naushad-rahman/LIFSrProj_F15/README.md

**Repository for Senior Project ECEn 490 Section 1, Fall 2015, BYU**
