naushad-rahman/LIFSrProj_F15/DSP/digital_filter_explore/150706_zero_phase_FIR_notes.png

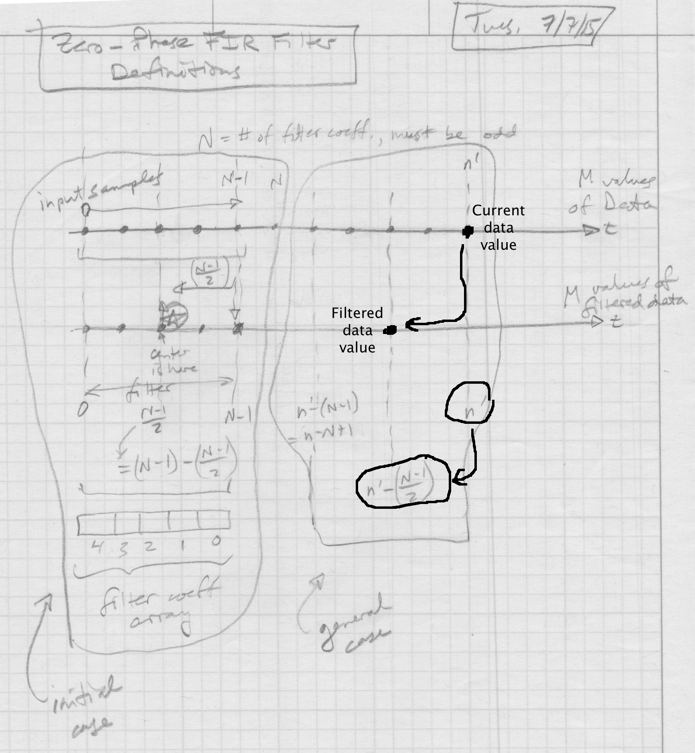
DSP/digital_filter_explore/150706_zero_phase_FIR_notes.png
