naushad-rahman/LIFSrProj_F15/High Voltage/HV Hardware LTSpice/Faulty HV schematic original.PNG

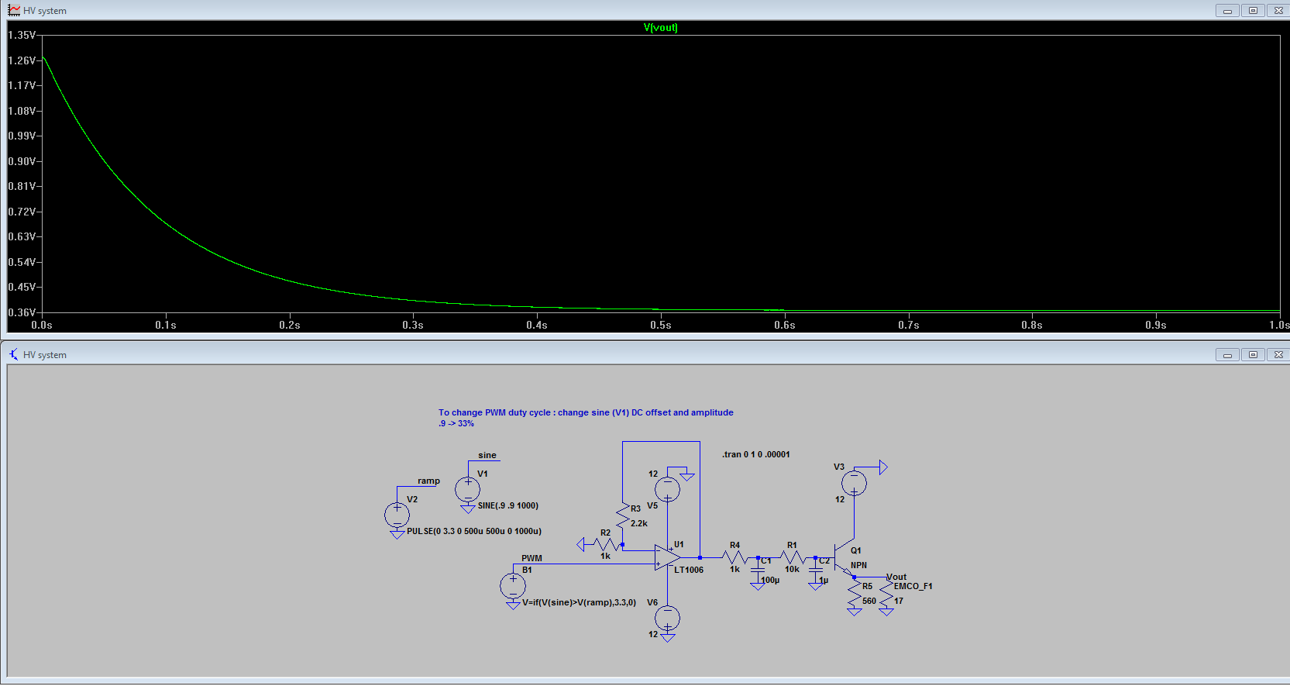
High Voltage/HV Hardware LTSpice/Faulty HV schematic original.PNG
