naushad-rahman/LIFSrProj_F15/High Voltage/HV Hardware LTSpice/HV change.PNG

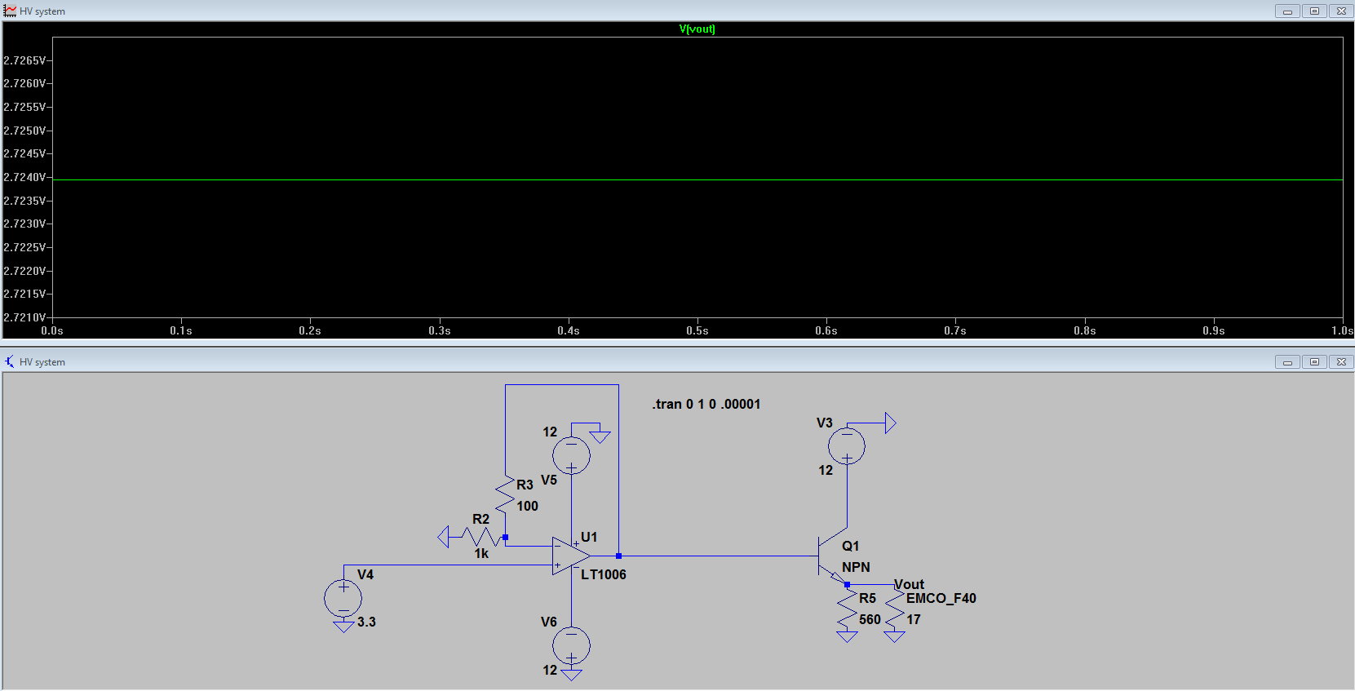
High Voltage/HV Hardware LTSpice/HV change.PNG
