naushad-rahman/LIFSrProj_F15/Laser_Driver/laser_current.jpg

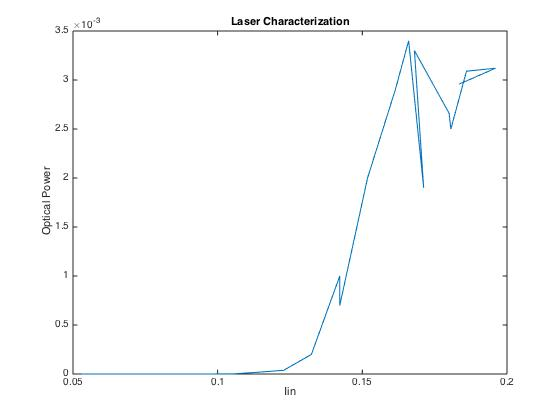
Laser_Driver/laser_current.jpg
