naushad-rahman/LIFSrProj_F15/Laser_Driver/laser_voltage.jpg

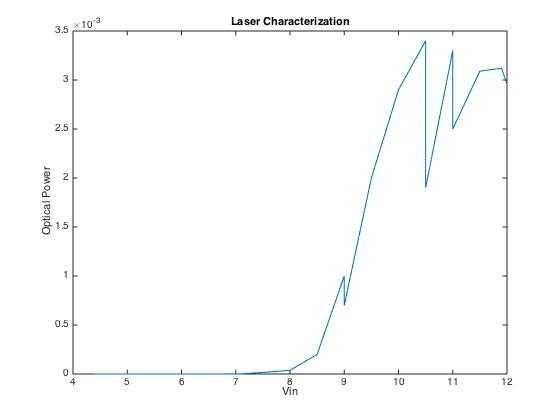
Laser_Driver/laser_voltage.jpg
