naushad-rahman/LIFSrProj_F15/CAD/Optical_Bench_current.stl

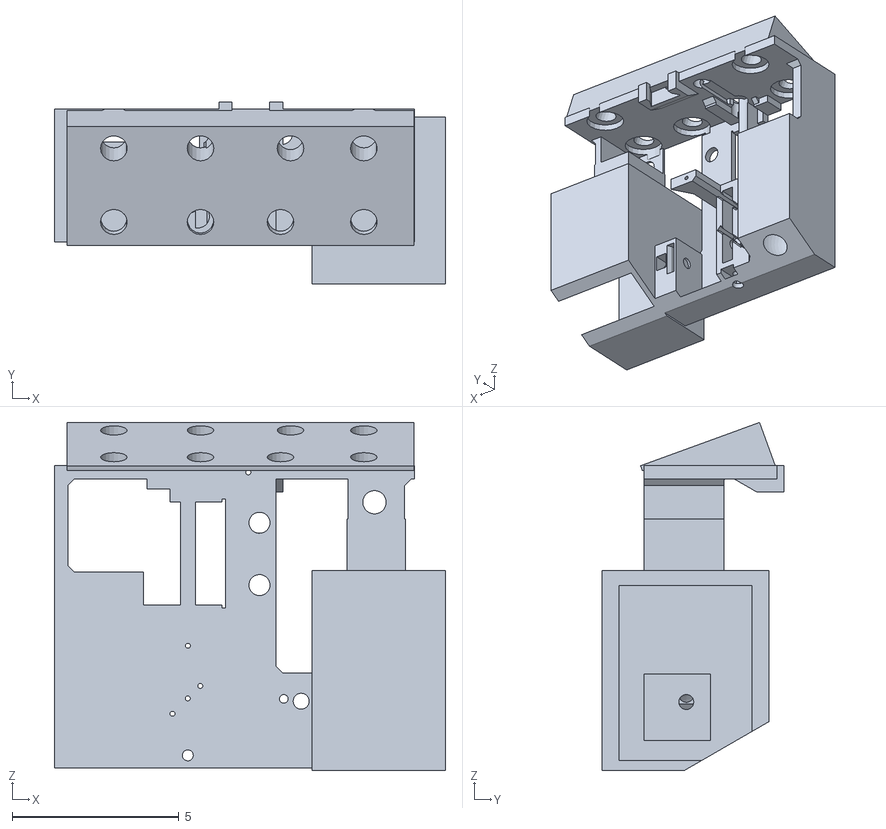
[picture p6: CAD file, 2015-12-16]
CAD/Optical_Bench_current.stl
11.7 x 5.45 x 10.4
