naushad-rahman/LIFSrProj_F15/CAD/sampleholderdraft5.stl

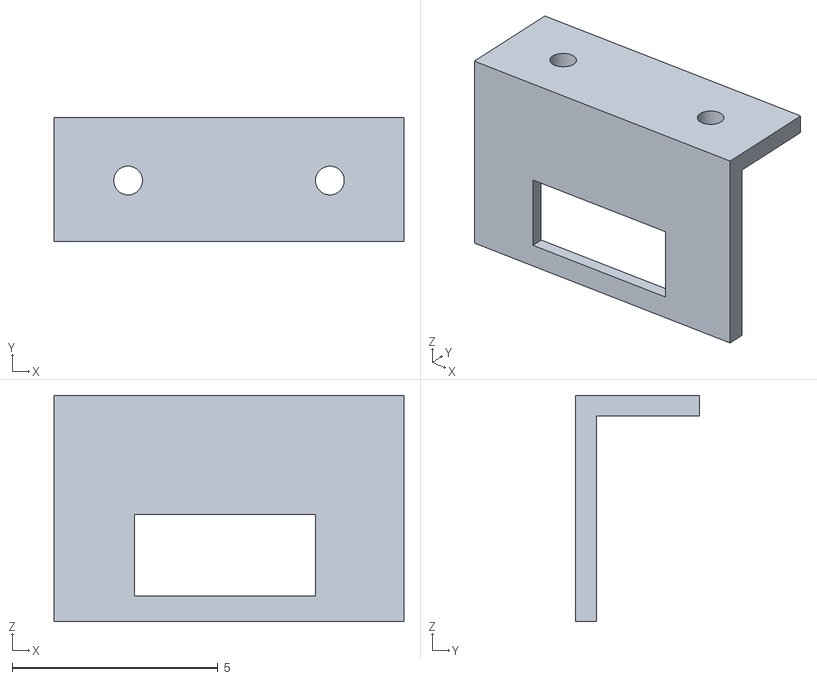
[picture p7: CAD file, 2015-12-16]
CAD/sampleholderdraft5.stl
8.50 x 3.00 x 5.50
