naushad-rahman/LIFSrProj_F15/CAD/490OpticalSystem.stl

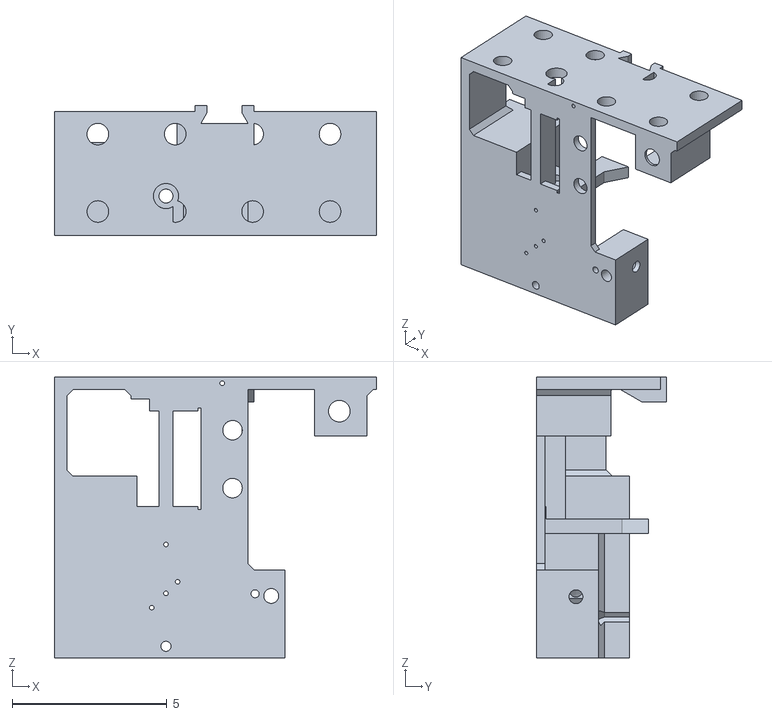
[picture p8: CAD file, 2015-12-16]
CAD/490OpticalSystem.stl
10.4 x 4.20 x 9.07
