naushad-rahman/LIFSrProj_F15/CAD/490HV_SampleConnector.stl

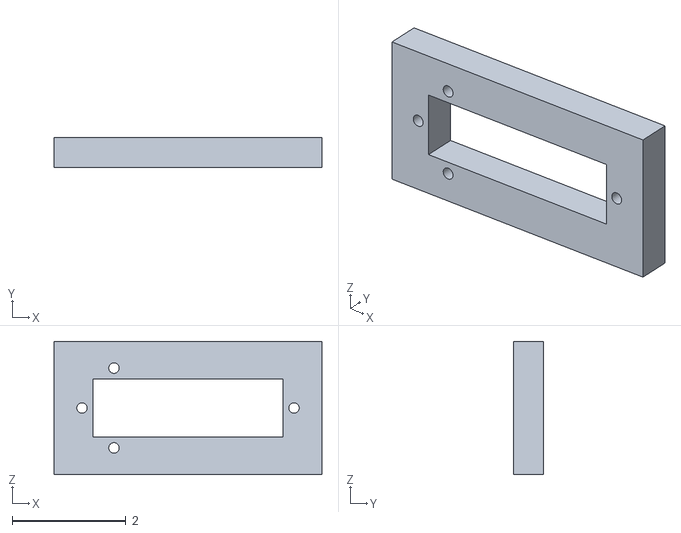
[picture p9: CAD file, 2015-12-16]
CAD/490HV_SampleConnector.stl
4.72 x 0.531 x 2.35
