naushad-rahman/LIFSrProj_F15/CAD/Sample_Holder.stl

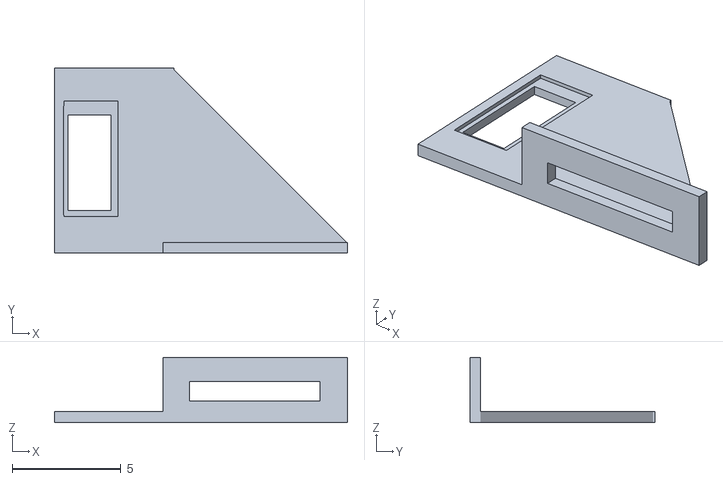
[picture p10: CAD file, 2015-12-16]
CAD/Sample_Holder.stl
13.5 x 8.50 x 3.00
