naushad-rahman/LIFSrProj_F15/CAD/Part1test1.STL

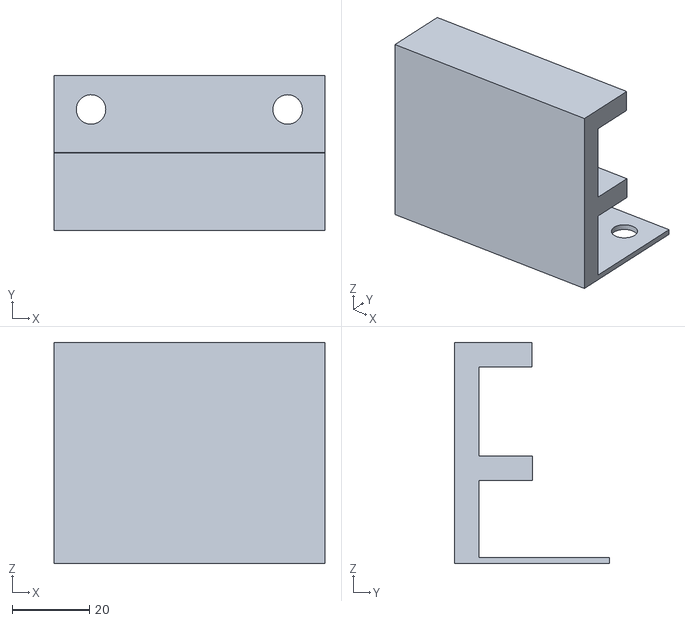
[picture p11: CAD file, 2015-05-13]
CAD/Part1test1.STL
70.0 x 40.0 x 57.1
