naushad-rahman/LIFSrProj_F15/Laser_Driver/old/PCB_Case_SCAD/Laser_Driver_Case.stl

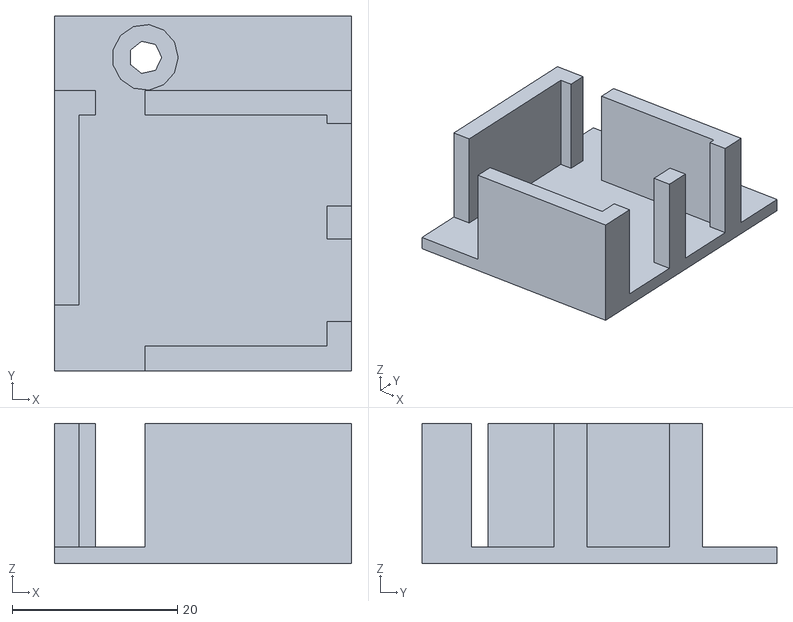
[picture p12: CAD file, 2015-07-07, an earlier design]
Laser_Driver/old/PCB_Case_SCAD/Laser_Driver_Case.stl
36.0 x 43.0 x 17.0
