naushad-rahman/LIFSrProj_F15/(list of files, cad)

Other CAD files:
Laser_Driver/old/PCB_Case_SCAD/Laser_Driver_Case.scad
CAD/490HV_SampleConnector.ipt
CAD/490OpticalSystem.ipt
CAD/sampleholderdraft5.ipt
