naushad-rahman/LIFSrProj_F15/DSP/150710_quick_test_data_file/RecordedData_2015710_91739.csv

#Data from 2015-7-10 at 9:17:39
Timestamp,PMT
34722839.0,0.0,34723059.0,0.0,34723271.0,0.0,34723474.0,0.0,34723677.0,0.0,34723885.0,0.0,34724087.0,0.0,34724291.0,0.0,34724498.0,0.0,34724703.0,0.0,34724906.0,0.0,34725110.0,0.0,34725315.0,0.0,34725518.0,0.0,34725720.0,0.0,34725927.0,0.0,34726134.0,0.0,34726339.0,0.0,34726542.0,0.0,34726746.0,0.0,34726950.0,0.0,34727155.0,0.0,34727432.0,0.0,34727634.0,0.0,34727845.0,0.0,34728049.0,0.0,34728254.0,0.0,34728457.0,0.0,34728661.0,0.0,34728865.0,0.0,34729069.0,0.0,34729275.0,0.0,34729481.0,0.0,34729686.0,0.0,34729893.0,0.0,34730096.0,0.0,34730300.0,0.0,34730504.0,0.0,34730708.0,0.0,34730913.0,0.0,34731122.0,0.0,34731329.0,0.0,34731532.0,0.0,34731736.0,0.0,34731943.0,0.0,34732146.0,0.0,34732351.0,0.0,34732554.0,0.0,34732834.0,0.0,34733039.0,0.0,34733244.0,0.0,34733448.0,0.0,34733650.0,0.0,34733858.0,0.0,34734061.0,0.0,34734266.0,0.0,34734473.0,0.0,34734679.0,0.0,34734883.0,0.0,34735087.0,0.0,34735293.0,0.0,34735496.0,0.0,34735699.0,0.0,34735908.0,0.0,34736116.0,0.0,34736322.0,0.0,34736526.0,0.0,34736730.0,0.0,34736936.0,0.0,34737141.0,0.0,34737347.0,0.0,34737551.0,0.0,34737835.0,0.0,34738040.0,0.0,34738246.0,0.0,34738450.0,0.0,34738655.0,0.0,34738860.0,0.0,34739064.0,0.0,34739269.0,0.0,34739476.0,0.0,34739681.0,0.0,34739888.0,0.0,34740092.0,0.0,34740296.0,0.0,34740501.0,0.0,34740706.0,0.0,34740911.0,0.0,34741120.0,0.0,34741327.0,0.0,34741530.0,0.0,34741733.0,0.0,34741941.0,0.0,34742145.0,0.0,34742350.0,0.0,34742555.0,0.0,34742837.0,0.0,34743043.0,0.0,34743249.0,0.0,34743452.0,0.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
