naushad-rahman/LIFSrProj_F15/Laser_Driver/laser_characterization/DATA08.CSV

S130C | 2015-10-20 08:06:08
value unit [W] | time unit [ms]
wavelength | 532.000nm
range | AUTO
1.553183E-06 | 39
1.549138E-06 | 340
1.545905E-06 | 639
1.542894E-06 | 940
1.539832E-06 | 1239
1.536917E-06 | 1540
1.534110E-06 | 1839
1.531068E-06 | 2140
1.528716E-06 | 2439
1.525757E-06 | 2740
1.523260E-06 | 3039
1.521030E-06 | 3340
1.518379E-06 | 3639
1.516029E-06 | 3940
1.513990E-06 | 4239
1.511333E-06 | 4540
1.509293E-06 | 4839
1.506943E-06 | 5140
1.504885E-06 | 5439
1.502391E-06 | 5740
1.500454E-06 | 6039
1.498570E-06 | 6340
1.496698E-06 | 6639
1.494748E-06 | 6941
1.492746E-06 | 7240
1.490912E-06 | 7541
1.489283E-06 | 7840
1.487522E-06 | 8141
1.485635E-06 | 8440
1.484040E-06 | 8741
1.482572E-06 | 9040
1.481111E-06 | 9341
1.479653E-06 | 9640
1.478056E-06 | 9941
1.477022E-06 | 10240
1.475877E-06 | 10541
1.474761E-06 | 10840
1.473905E-06 | 11141
1.473311E-06 | 11440
1.472351E-06 | 11741
1.471879E-06 | 12040
1.471183E-06 | 12341
1.470753E-06 | 12640
1.470594E-06 | 12941
1.470313E-06 | 13240
1.470082E-06 | 13541
1.469858E-06 | 13840
1.469692E-06 | 14141
1.469418E-06 | 14440
1.469210E-06 | 14742
1.469069E-06 | 15041
1.468889E-06 | 15342
1.468686E-06 | 15641
1.468445E-06 | 15942
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
