naushad-rahman/LIFSrProj_F15/Laser_Driver/laser_characterization/volts10.CSV

S130C | 2015-10-20 07:33:29
value unit [W] | time unit [ms]
wavelength | 532.000nm
range | AUTO
2.546424E-03 | 220
2.545920E-03 | 520
2.545224E-03 | 820
2.544641E-03 | 1120
2.543968E-03 | 1420
2.543207E-03 | 1720
2.542849E-03 | 2020
2.542211E-03 | 2320
2.541432E-03 | 2620
2.540848E-03 | 2920
2.540513E-03 | 3220
2.539792E-03 | 3520
2.539329E-03 | 3820
2.538506E-03 | 4120
2.537997E-03 | 4420
2.537518E-03 | 4720
2.536834E-03 | 5020
2.536171E-03 | 5320
2.535811E-03 | 5620
2.535106E-03 | 5920
2.534492E-03 | 6220
2.533899E-03 | 6520
2.533161E-03 | 6820
2.532531E-03 | 7120
2.532033E-03 | 7420
2.531388E-03 | 7720
2.530974E-03 | 8020
2.530031E-03 | 8320
2.529373E-03 | 8620
2.528820E-03 | 8920
2.528203E-03 | 9220
2.527528E-03 | 9520
2.526885E-03 | 9820
2.526278E-03 | 10120
2.525770E-03 | 10420
2.524904E-03 | 10720
2.524136E-03 | 11020
2.523424E-03 | 11320
2.522815E-03 | 11620
2.522301E-03 | 11920
2.521534E-03 | 12220
2.520622E-03 | 12520
2.519996E-03 | 12820
2.519263E-03 | 13120
2.518451E-03 | 13420
2.517566E-03 | 13720
2.516850E-03 | 14020
2.516168E-03 | 14320
2.515301E-03 | 14620
2.514498E-03 | 14920
2.513745E-03 | 15220
2.512871E-03 | 15520
2.511941E-03 | 15820
2.511003E-03 | 16120
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
