naushad-rahman/LIFSrProj_F15/Laser_Driver/laser_characterization/volts11.CSV

S130C | 2015-10-20 08:00:30
value unit [W] | time unit [ms]
wavelength | 532.000nm
range | AUTO
3.248866E-03 | 247
3.255341E-03 | 547
3.256170E-03 | 847
3.251293E-03 | 1147
3.249867E-03 | 1447
3.248355E-03 | 1747
3.247948E-03 | 2047
3.251927E-03 | 2347
3.255989E-03 | 2647
3.256274E-03 | 2947
3.255891E-03 | 3247
3.255802E-03 | 3547
3.256600E-03 | 3847
3.256731E-03 | 4147
3.224495E-03 | 4447
3.220850E-03 | 4747
3.224994E-03 | 5047
3.223985E-03 | 5347
3.210622E-03 | 5647
3.200900E-03 | 5947
3.189092E-03 | 6247
3.181300E-03 | 6547
3.175416E-03 | 6847
3.168528E-03 | 7148
3.161390E-03 | 7448
3.154257E-03 | 7748
3.145422E-03 | 8048
3.114137E-03 | 8348
3.094926E-03 | 8648
3.093215E-03 | 8948
3.090397E-03 | 9248
3.087065E-03 | 9548
3.083566E-03 | 9848
3.080058E-03 | 10148
3.076824E-03 | 10448
3.073927E-03 | 10748
3.071255E-03 | 11048
3.068627E-03 | 11348
3.066242E-03 | 11648
3.063805E-03 | 11948
3.061452E-03 | 12248
3.059033E-03 | 12548
3.056796E-03 | 12848
3.054654E-03 | 13148
3.052494E-03 | 13448
3.050487E-03 | 13748
3.048627E-03 | 14048
3.046888E-03 | 14348
3.045252E-03 | 14648
3.043862E-03 | 14949
3.042537E-03 | 15249
3.041375E-03 | 15549
3.040365E-03 | 15849
3.039425E-03 | 16149
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
