naushad-rahman/LIFSrProj_F15/Laser_Driver/laser_characterization/volts7.CSV

S130C | 2015-10-20 07:54:25
value unit [W] | time unit [ms]
wavelength | 532.000nm
range | AUTO
6.053699E-07 | 159
6.071819E-07 | 459
6.086942E-07 | 759
6.101237E-07 | 1059
6.113856E-07 | 1359
6.123822E-07 | 1659
6.133184E-07 | 1959
6.154341E-07 | 2259
6.174014E-07 | 2559
6.184221E-07 | 2859
6.183475E-07 | 3159
6.174891E-07 | 3459
6.156070E-07 | 3759
6.129005E-07 | 4059
6.097303E-07 | 4359
6.097455E-07 | 4659
6.102665E-07 | 4959
6.107759E-07 | 5259
6.111105E-07 | 5559
6.103008E-07 | 5859
6.092889E-07 | 6159
6.054158E-07 | 6459
5.951748E-07 | 6759
5.709547E-07 | 7060
5.441119E-07 | 7360
5.279561E-07 | 7660
5.199641E-07 | 7960
5.161821E-07 | 8260
5.144019E-07 | 8560
5.137715E-07 | 8860
5.135489E-07 | 9160
5.141556E-07 | 9460
5.145394E-07 | 9760
5.152604E-07 | 10060
5.159445E-07 | 10360
5.172130E-07 | 10660
5.184423E-07 | 10960
5.197980E-07 | 11260
5.215258E-07 | 11560
5.231243E-07 | 11860
5.247125E-07 | 12160
5.264335E-07 | 12460
5.282753E-07 | 12760
5.302308E-07 | 13060
5.317009E-07 | 13360
5.334659E-07 | 13660
5.351757E-07 | 13960
5.366812E-07 | 14260
5.381312E-07 | 14560
5.394784E-07 | 14861
5.408613E-07 | 15161
5.418673E-07 | 15461
5.427761E-07 | 15761
5.437080E-07 | 16061
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
