naushad-rahman/LIFSrProj_F15/Laser_Driver/laser_characterization/volts8.CSV

S130C | 2015-10-20 07:46:30
value unit [W] | time unit [ms]
wavelength | 532.000nm
range | AUTO
8.238483E-06 | 40
7.904884E-06 | 339
7.671832E-06 | 640
7.456650E-06 | 939
7.256574E-06 | 1240
7.068492E-06 | 1539
6.890770E-06 | 1840
6.724180E-06 | 2139
6.567199E-06 | 2440
6.416788E-06 | 2739
6.270931E-06 | 3040
6.127748E-06 | 3339
5.997316E-06 | 3640
5.932677E-06 | 3939
5.887670E-06 | 4240
5.849877E-06 | 4539
5.816668E-06 | 4840
5.781548E-06 | 5139
5.742066E-06 | 5440
5.699232E-06 | 5739
5.650787E-06 | 6040
5.591548E-06 | 6339
5.516836E-06 | 6640
5.434976E-06 | 6941
5.367165E-06 | 7241
5.328515E-06 | 7541
5.313917E-06 | 7841
5.310452E-06 | 8141
5.310367E-06 | 8441
5.312096E-06 | 8741
5.313202E-06 | 9041
5.312822E-06 | 9341
5.308474E-06 | 9641
5.302384E-06 | 9941
5.295878E-06 | 10241
5.288996E-06 | 10541
5.283277E-06 | 10841
5.277214E-06 | 11141
5.271861E-06 | 11441
5.266379E-06 | 11741
5.261545E-06 | 12041
5.257118E-06 | 12341
5.252751E-06 | 12641
5.248984E-06 | 12941
5.244554E-06 | 13241
5.239569E-06 | 13541
5.234432E-06 | 13841
5.228467E-06 | 14141
5.221327E-06 | 14441
5.214114E-06 | 14742
5.205903E-06 | 15042
5.197456E-06 | 15342
5.188346E-06 | 15642
5.178873E-06 | 15942
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
