naushad-rahman/LIFSrProj_F15/Laser_Driver/laser_characterization/volts9.CSV

S130C | 2015-10-20 07:40:01
value unit [W] | time unit [ms]
wavelength | 532.000nm
range | AUTO
2.441054E-04 | 259
2.450675E-04 | 559
2.460240E-04 | 859
2.469660E-04 | 1159
2.480400E-04 | 1459
2.496795E-04 | 1759
2.515052E-04 | 2059
2.537955E-04 | 2359
2.569477E-04 | 2659
2.602451E-04 | 2959
2.626753E-04 | 3259
2.634506E-04 | 3559
2.613236E-04 | 3859
2.611561E-04 | 4159
2.603242E-04 | 4459
2.625363E-04 | 4759
2.672985E-04 | 5059
2.718100E-04 | 5359
2.765493E-04 | 5659
2.816284E-04 | 5959
2.869137E-04 | 6259
2.922807E-04 | 6559
2.977055E-04 | 6859
3.032390E-04 | 7160
3.087802E-04 | 7460
3.143749E-04 | 7760
3.202376E-04 | 8060
3.267781E-04 | 8360
3.343942E-04 | 8660
3.429701E-04 | 8960
3.515280E-04 | 9260
3.594198E-04 | 9560
3.668987E-04 | 9860
3.743986E-04 | 10160
3.819503E-04 | 10460
3.899895E-04 | 10760
3.989221E-04 | 11060
4.080630E-04 | 11360
4.166477E-04 | 11660
4.244143E-04 | 11960
4.313773E-04 | 12260
4.379106E-04 | 12560
4.443096E-04 | 12860
4.507424E-04 | 13160
4.574345E-04 | 13460
4.644266E-04 | 13760
4.716440E-04 | 14060
4.789869E-04 | 14360
4.863913E-04 | 14660
4.937592E-04 | 14961
5.010017E-04 | 15261
5.079873E-04 | 15561
5.147238E-04 | 15861
5.210619E-04 | 16161
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
