naushad-rahman/LIFSrProj_F15/Laser_Driver/laser_characterization/volts11_graph.png

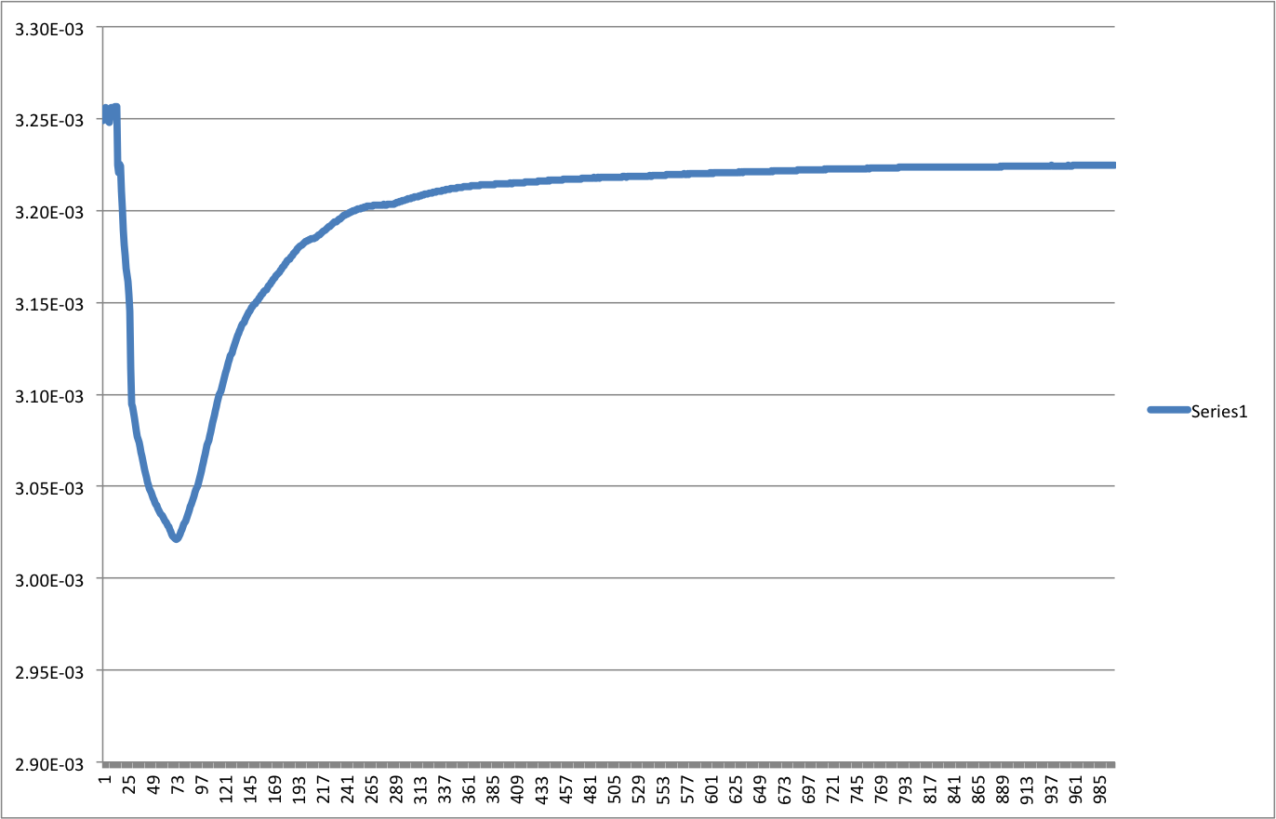
Laser_Driver/laser_characterization/volts11_graph.png
