naushad-rahman/LIFSrProj_F15/testing/test_pmt_raw_data/test_raw_data_150728_PMTcovered_lights_off.PNG

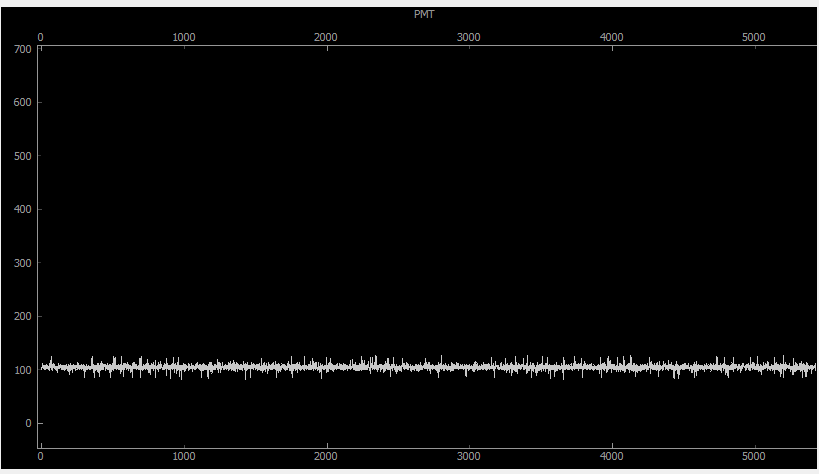
testing/test_pmt_raw_data/test_raw_data_150728_PMTcovered_lights_off.PNG
