naushad-rahman/LIFSrProj_F15/testing/test_pmt_raw_data/test_raw_data_150728_rhodamine.PNG

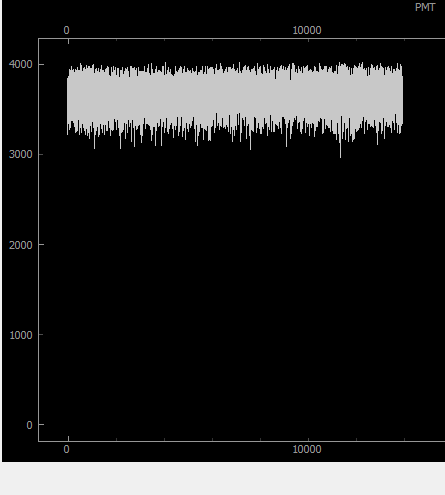
testing/test_pmt_raw_data/test_raw_data_150728_rhodamine.PNG
