naushad-rahman/LIFSrProj_F15/testing/test_pmt_raw_data/test_raw_data_150807_rhodamine_in_channel.PNG

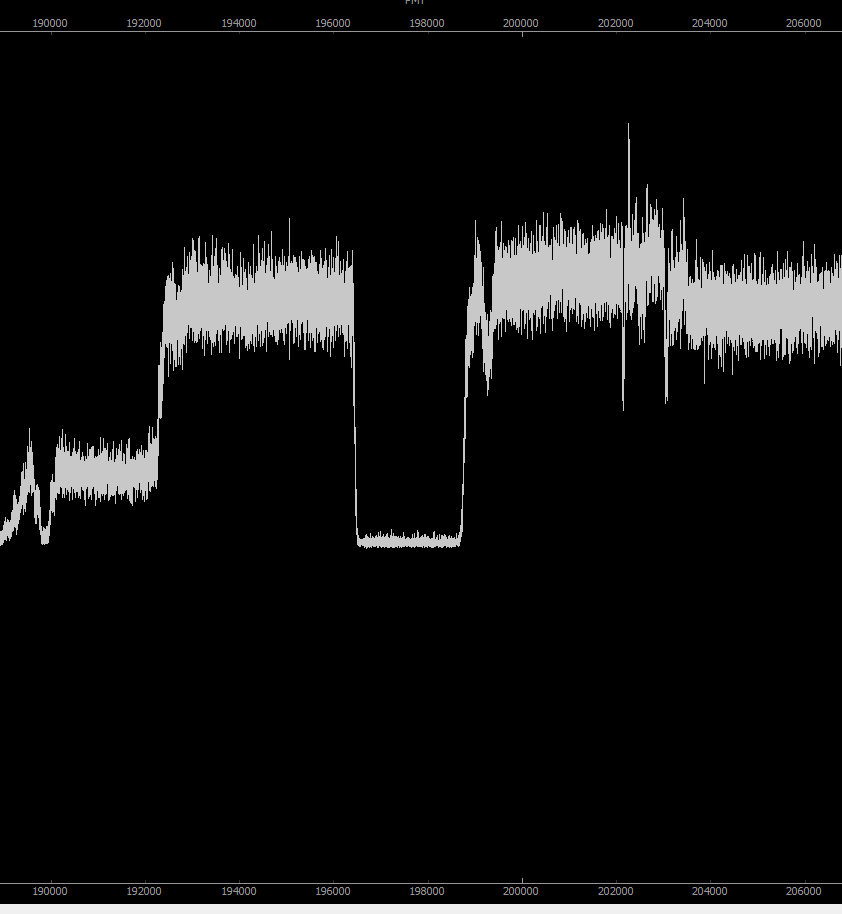
testing/test_pmt_raw_data/test_raw_data_150807_rhodamine_in_channel.PNG
