naushad-rahman/LIFSrProj_F15/information_examples/Dye separation examples-Mukul.pdf

# Dyes

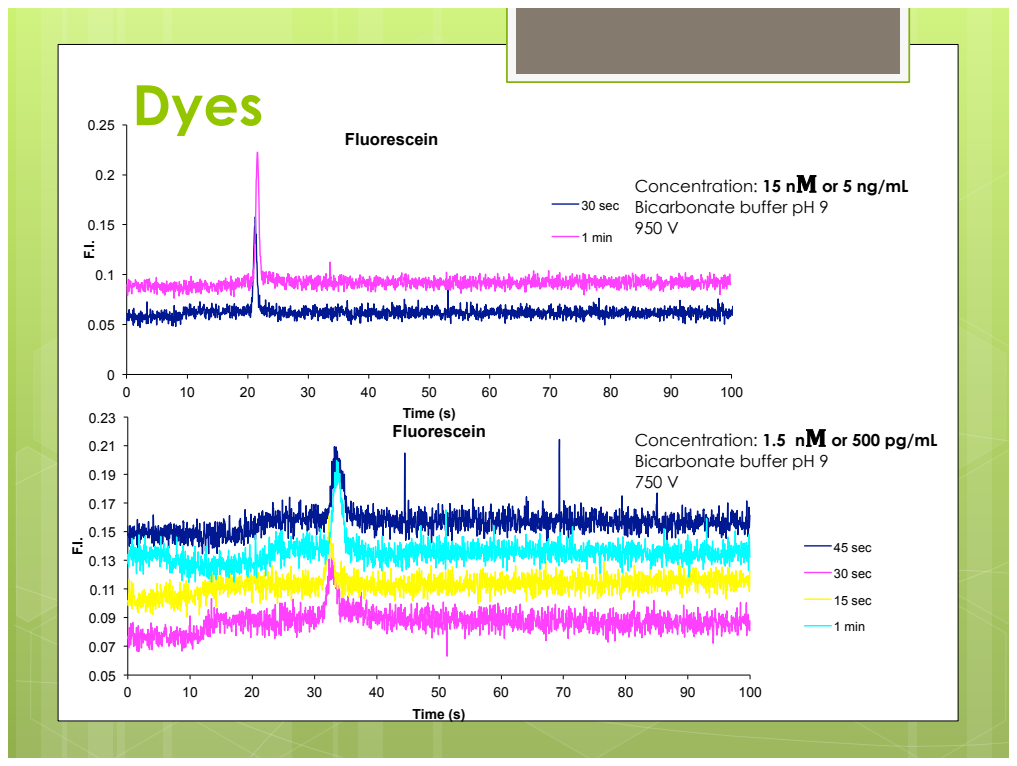
[picture p39: page 1]
Time (s); Fluorescein; 45 sec; 30 sec; 15 sec; 1 min

Concentration: 15 nM or 5 ng/mL
Bicarbonate buffer pH 9

Concentration: 1.5 nM or 500 pg/mL

# Dyes

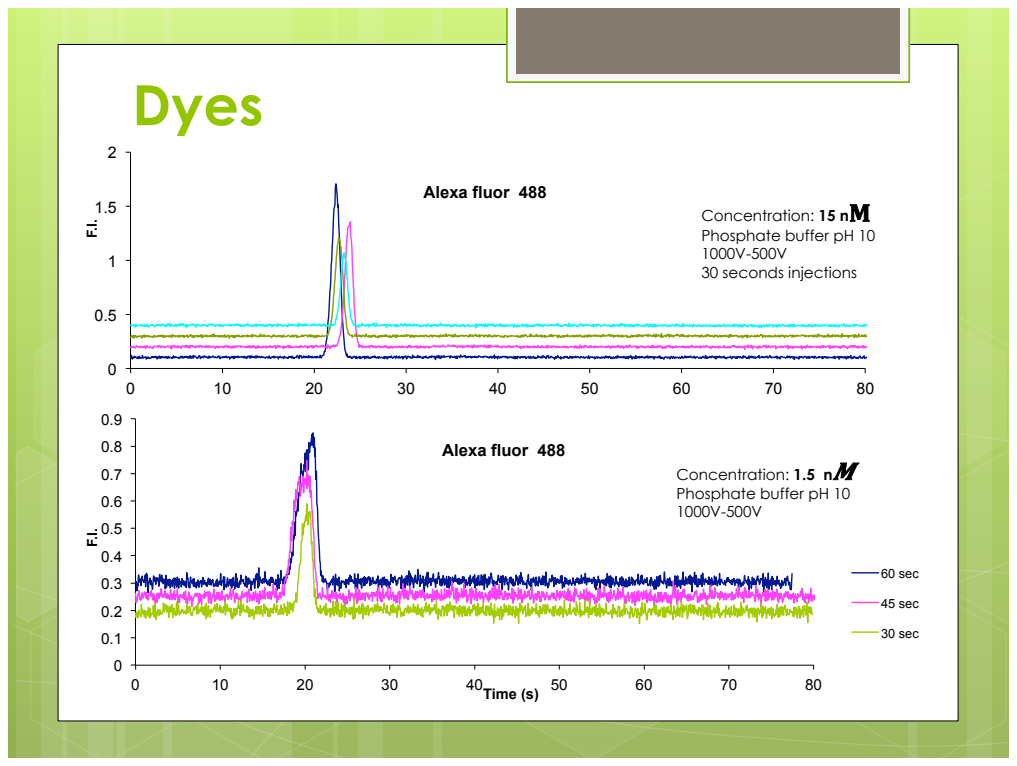
[picture p40: page 2]
Time (s); Alexa fluor 488; 60 sec; 45 sec; 30 sec

Concentration: 15 nM
Phosphate buffer pH 10
30 seconds injections

Concentration: 1.5 nM
