naushad-rahman/LIFSrProj_F15/High Voltage/HV Hardware LTSpice/HV system.asc

EMCO_F40: res; 17
Q1: npn
R2: res; 1k
R3: res; 100
R5: res; 560
U1: LT1006
V3: voltage; 12
V4: voltage; 3.3
V5: voltage; 12
V6: voltage; 12
Named nets: 0, Vout
.tran 0 1 0 .00001
