naushad-rahman/LIFSrProj_F15/High Voltage/HV Hardware LTSpice/HV system_New_board_original.asc

B1: bv; V=if(V(sine)>V(ramp),3.3,0)
C1: cap; 100µ
C2: cap; 1µ
EMCO_F1: res; 17
Q1: npn
R1: res; 10k
R2: res; 1k
R3: res; 2.2k
R4: res; 1k
R5: res; 560
U1: LT1006
V1: voltage; SINE(.9 .9 1000)
V2: voltage; PULSE(0 3.3 0 500u 500u 0 1000u)
V3: voltage; 12
V5: voltage; 12
V6: voltage; 12
Named nets: 0, sine, ramp, PWM, Vout
.tran 0 1 0 .00001
