naushad-rahman/LIFSrProj_F15/DSP/Analog_LPF/PMTLowPassFilter.asc

C1: cap; .1µ
C2: cap; .01µ
POT: res; 0-10k
R1: res; 470
R2: res; 560
R4: res; 1k
R5: res; 1k
U1: LT1677
V1: voltage; 2.5; AC .5
V2: voltage; 3.3
Named nets: 0, PMT, Vout
.ac dec 101 10 20k
