naushad-rahman/LIFSrProj_F15/(list of files, drawings)

Other design files:
Laser_Driver/old/Altium/driver.SchDoc
Laser_Driver/old/Altium/Laser_Driver.PcbDoc
Laser_Driver/old/Altium/Laser_Driver.PrjPcb
