naushad-rahman/LIFSrProj_F15/High Voltage/Kicad/Parent Folder.kicad_pcb

## KiCad design High Voltage/Kicad/Parent Folder.kicad_pcb (2015-05-15)

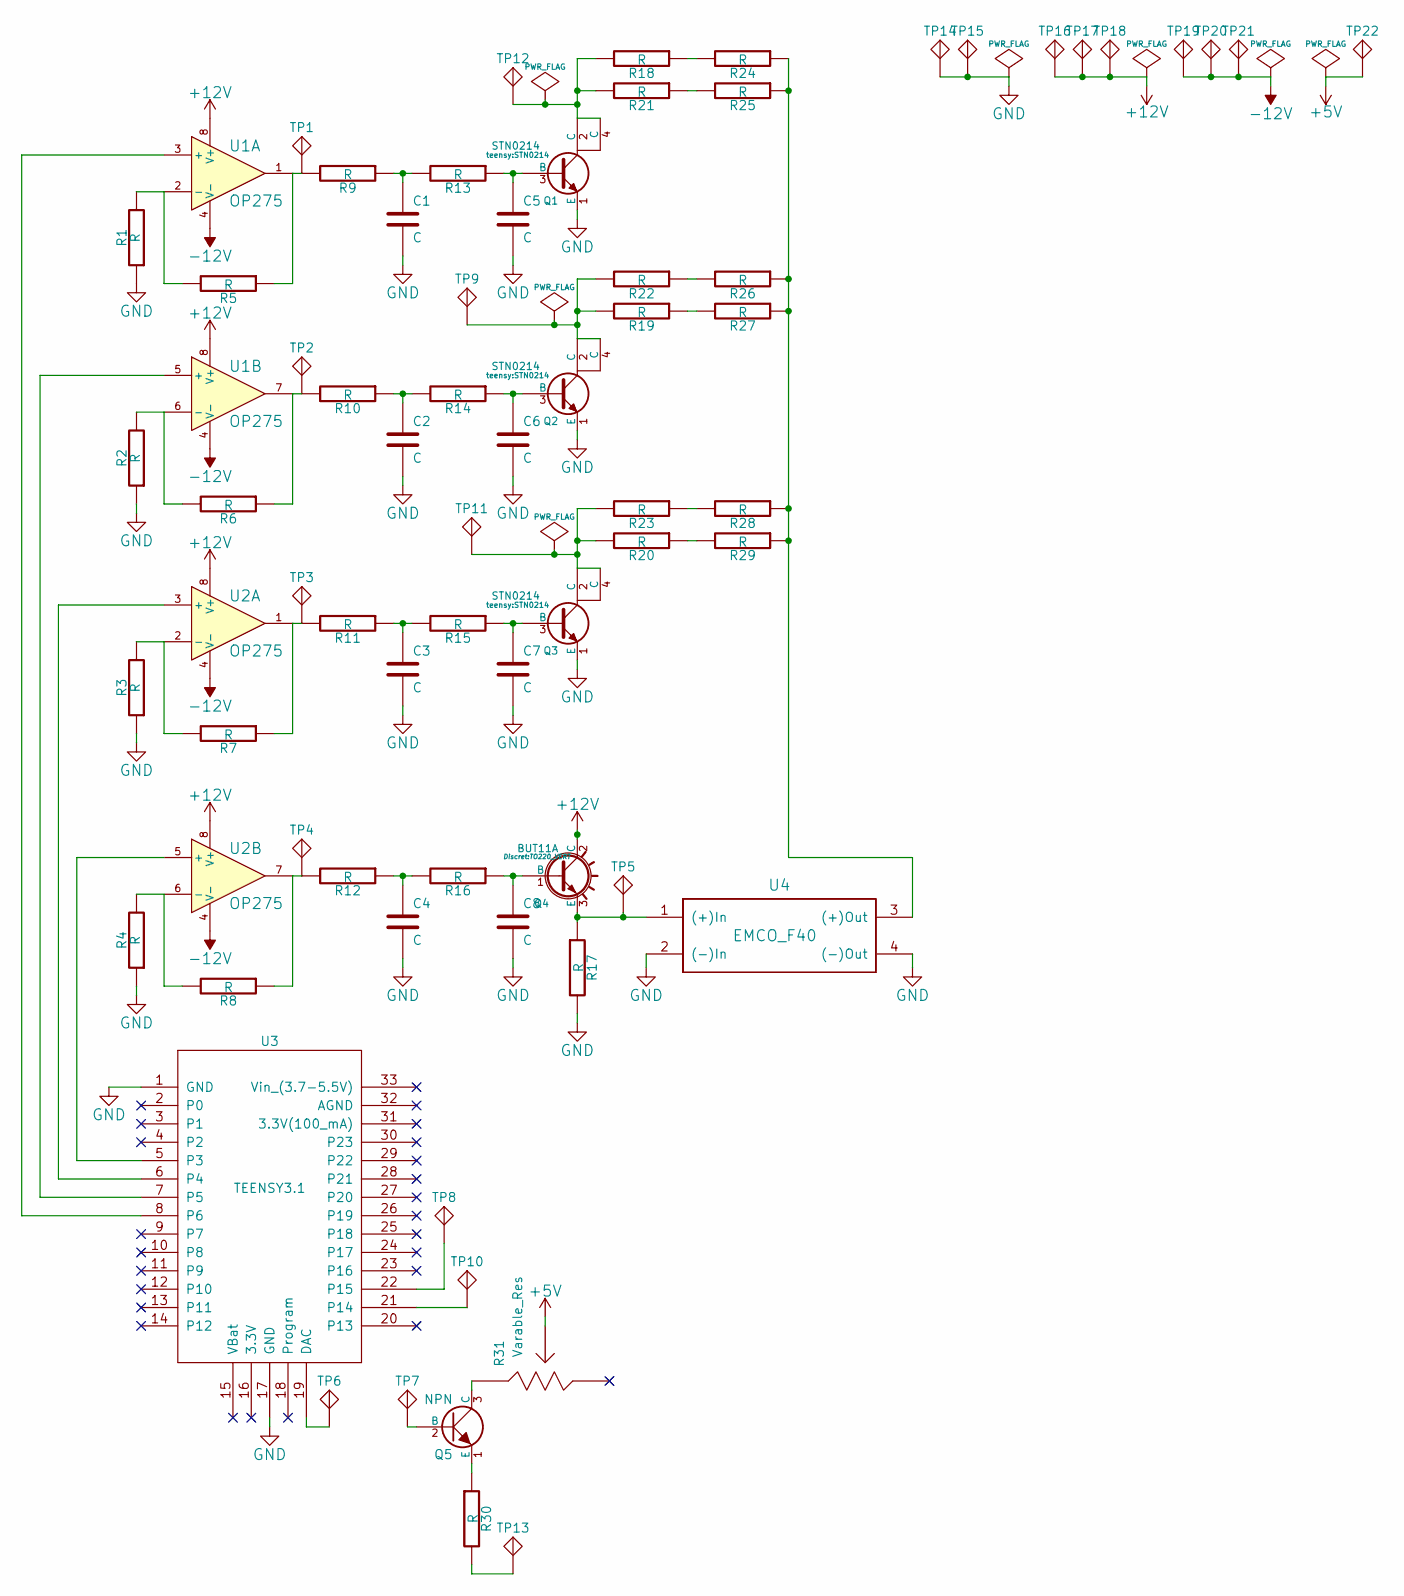
[picture p41: schematic Parent Folder.sch]

Parts:
C1, C2, C3, C4, C5, C6, C7, C8: C; C_1206_HandSoldering
Q1, Q2, Q3: STN0214
Q4: BUT11A; TO220_VERT
Q5: NPN; TO220_VERT
R1, R2, R3, R4, R5, R6, R7, R8, R9, R10, R11, R12, R13, R14, R15, R16, R17, R30: R; R_1206_HandSoldering
R18, R19, R20, R21, R22, R23, R24, R25, R26, R27, R28, R29: R; RES_1W
R31: Varable_Res; POT
TP1, TP2, TP3, TP4, TP5, TP6, TP7, TP8, TP9, TP10, TP11, TP12, TP13, TP14, TP15, TP16, TP17, TP18, TP19, TP20, TP21, TP22: Test_point; PINTST
U1, U2: OP275; OpAmp
U3: TEENSY3.1
U4: EMCO_F40

Connections:
+5V: R31.2, TP22.1
+12V: Q4.2 (C), TP16.1, TP17.1, TP18.1, U1.8 (V+), U2.8 (V+)
-12V: TP19.1, TP20.1, TP21.1, U1.4 (V-), U2.4 (V-)
GND: C1.2, C2.2, C3.2, C4.2, C5.2, C6.2, C7.2, C8.2, Q1.1 (E), Q2.1 (E), Q3.1 (E), R1.1, R2.1, R3.1, R4.1, R17.2, TP14.1, TP15.1, U3.1 (GND), U3.17 (GND), U4.2 ((-)In), U4.4 ((-)Out)
unnamed: C1.1, R9.1, R13.2
unnamed: C2.1, R10.1, R14.2
unnamed: C3.1, R11.1, R15.2
unnamed: C4.1, R12.1, R16.2
unnamed: C5.1, Q1.3 (B), R13.1
unnamed: C6.1, Q2.3 (B), R14.1
unnamed: C7.1, Q3.3 (B), R15.1
unnamed: C8.1, Q4.1 (B), R16.1
unnamed: Q1.2 (C), Q1.4 (C), R18.2, R21.2, TP12.1
unnamed: Q2.2 (C), Q2.4 (C), R19.2, R22.2, TP9.1
unnamed: Q3.2 (C), Q3.4 (C), R20.2, R23.2, TP11.1
unnamed: Q4.3 (E), R17.1, TP5.1, U4.1 ((+)In)
unnamed: Q5.1 (E), R30.1
unnamed: Q5.2 (B), TP7.1
unnamed: Q5.3 (C), R31.1
unnamed: R1.2, R5.2, U1.2 (-)
unnamed: R2.2, R6.2, U1.6 (-)
unnamed: R3.2, R7.2, U2.2 (-)
unnamed: R4.2, R8.2, U2.6 (-)
unnamed: R5.1, R9.2, TP1.1, U1.1
unnamed: R6.1, R10.2, TP2.1, U1.7
unnamed: R7.1, R11.2, TP3.1, U2.1
unnamed: R8.1, R12.2, TP4.1, U2.7
unnamed: R18.1, R24.2
unnamed: R19.1, R27.2
unnamed: R20.1, R29.2
unnamed: R21.1, R25.2
unnamed: R22.1, R26.2
unnamed: R23.1, R28.2
unnamed: R24.1, R25.1, R26.1, R27.1, R28.1, R29.1, U4.3 ((+)Out)
unnamed: R30.2, TP13.1
unnamed: TP6.1, U3.19 (DAC)
unnamed: TP8.1, U3.22 (P15)
unnamed: TP10.1, U3.21 (P14)
unnamed: U1.3 (+), U3.8 (P6)
unnamed: U1.5 (+), U3.7 (P5)
unnamed: U2.3 (+), U3.6 (P4)
unnamed: U2.5 (+), U3.5 (P3)

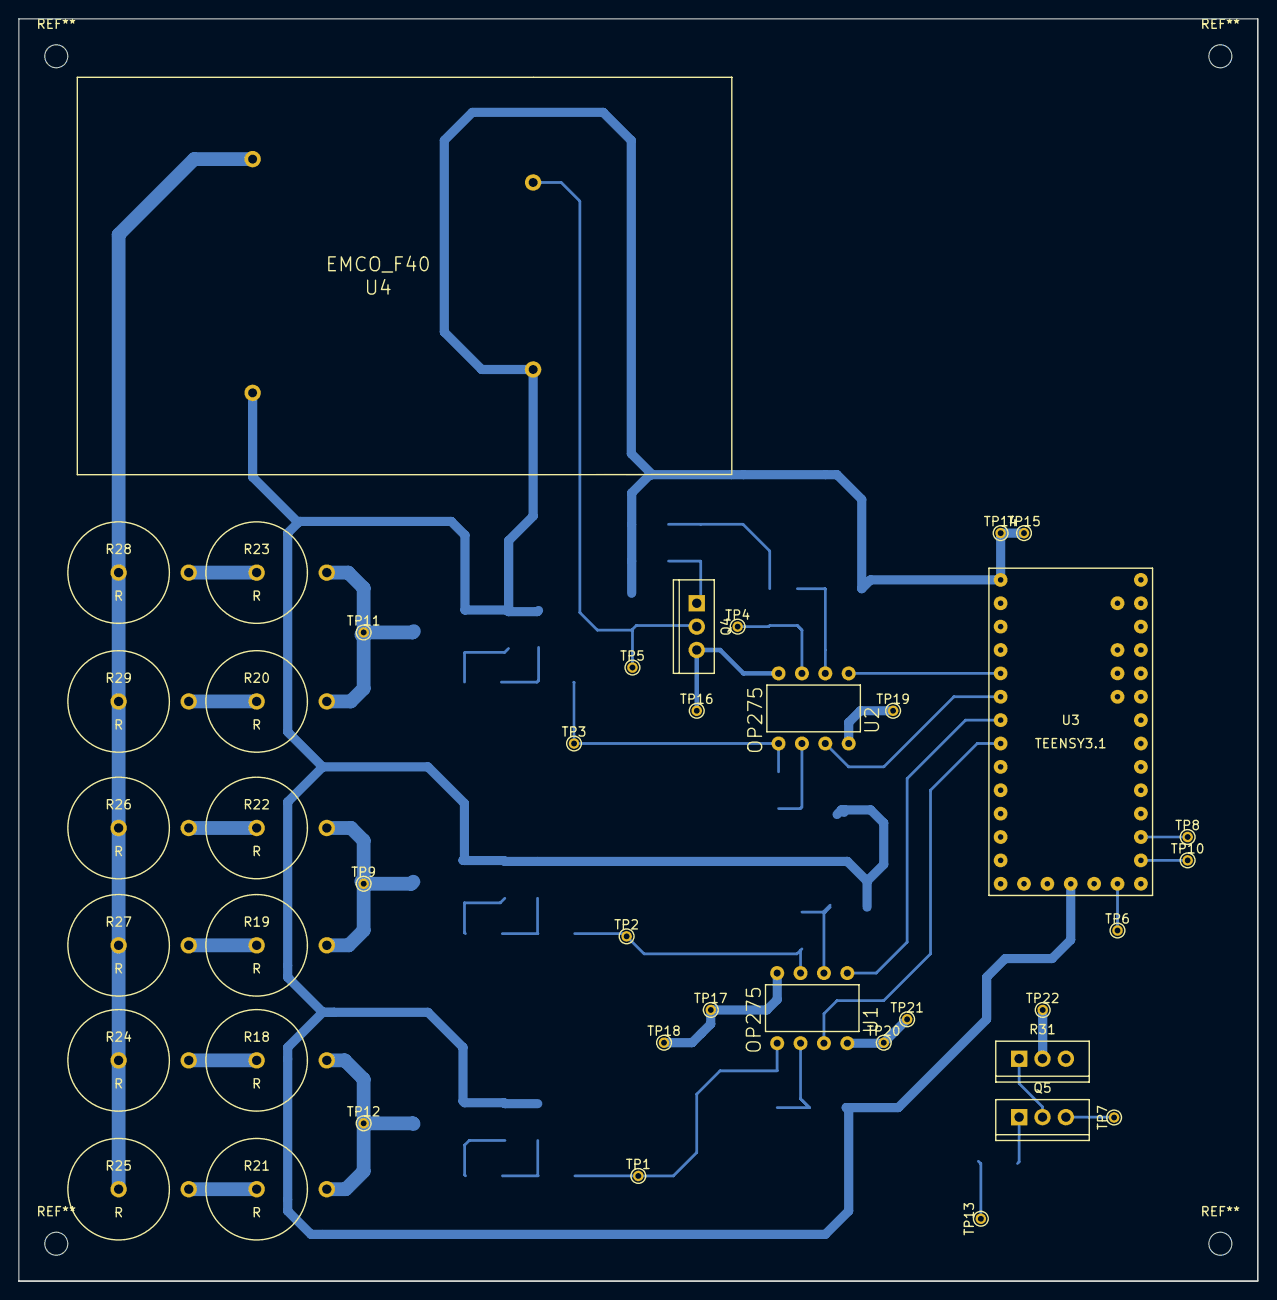
[picture p42: board Parent Folder.kicad_pcb from above]

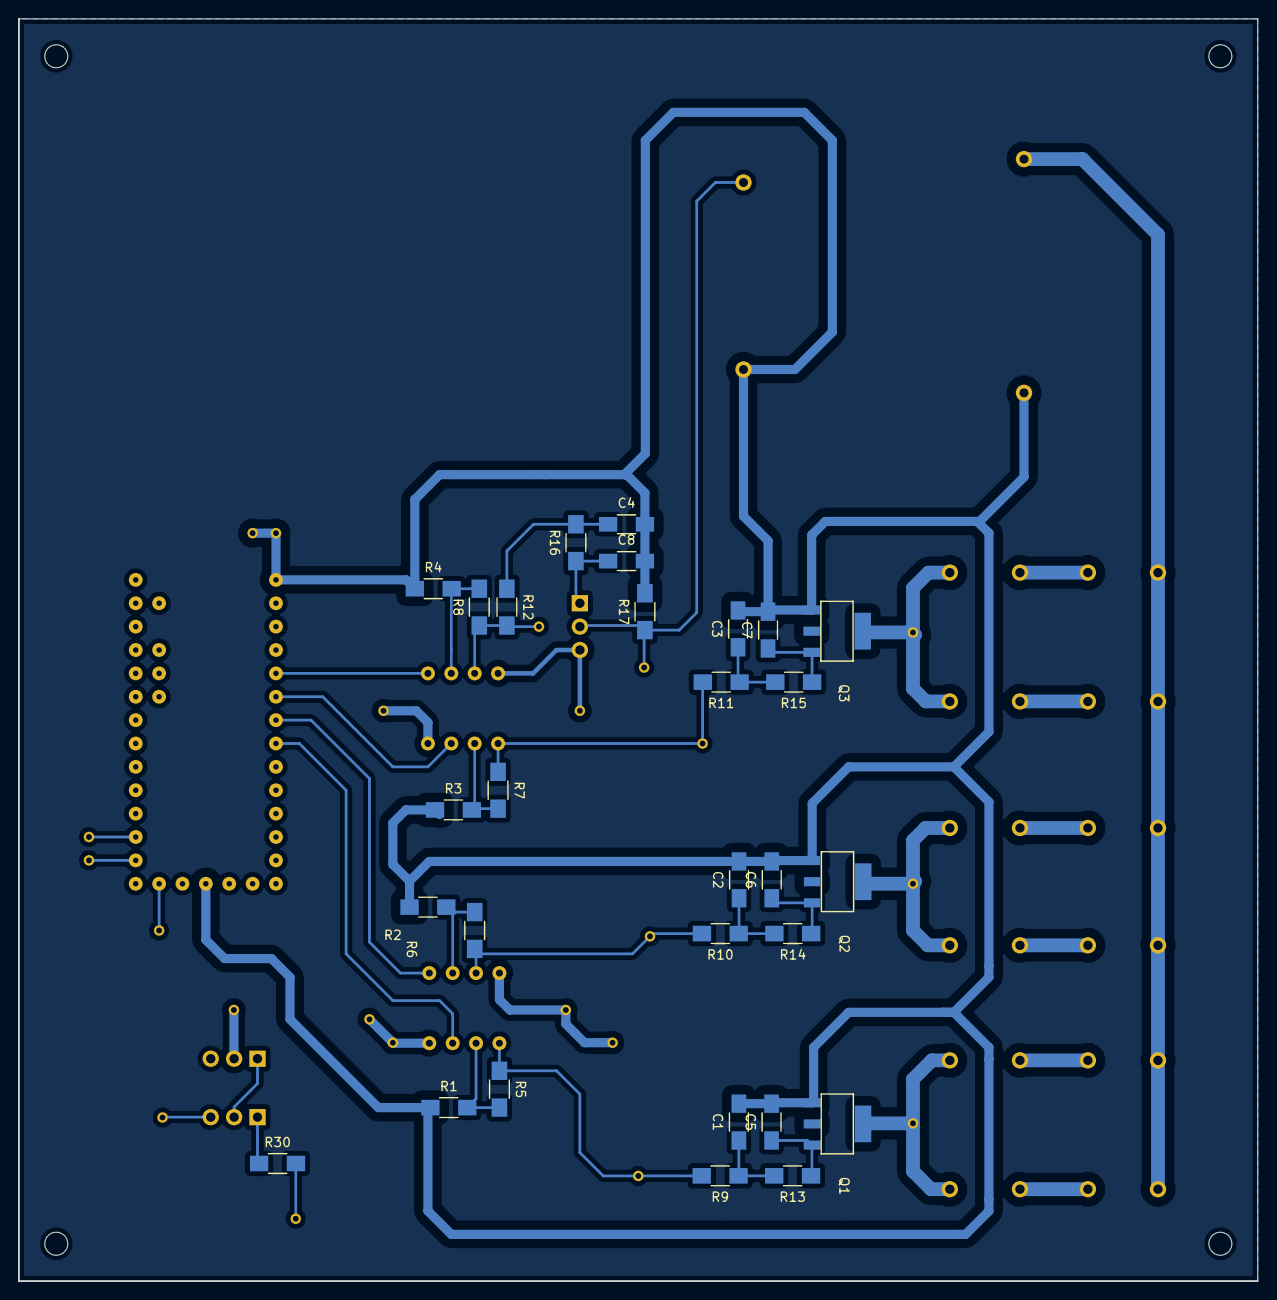
[picture p43: board Parent Folder.kicad_pcb from below]

Board: 2 copper layers, 134.6 x 137.2 mm, 70 parts (29 on the bottom side), 42 nets.
