naushad-rahman/LIFSrProj_F15/DSP/tests/test_new_LPFcoef_SG_150804/test_new_LPFcoef_SG_150804.ino

/*
 * Use simulated data and apply bandpass filter with normalized coefficients and zero-phase.
 * 
 * Key variables:
 * 
 *   test_signal - array with simulated data that is calculated in setup()
 *   in_array - buffer containing 37 samples consisting of the current and previous 36 samples
 *   after_bp - array containing the current and previous 36 samples passed through the bandpass filter
 *   index_test_signal - index of current value from test_signal
 *   index_in_array - index of current value of in_array and after_bp
 * 
 * 
 */

#include "/home/samuelwg/Arduino/libraries/ADC/ADC-master/ADC.h"
//#include "/Users/nordin/Documents/Arduino/libraries/ADC-master/ADC.h"

// 1=raised cosine (calculated), 2=impulse, 3=raised cosine from lut, 4=rectangular pulse, 
// 5=rectangular modulation of raised cosine, 6=Gaussian modulation of raised cosine
#define SIMULATED_SIGNAL_SELECTION 6

#define BAUD_RATE 115200
#define TIMER_INT_MICROS 800
#define LENGTH_OF_DAC 10
#define LENGTH_OF_SIGNAL 37
#define N_FILTER_LENGTH 37
#define LENGTH_OF_TEST_SIGNAL 1000
#define OUTPUT_SAMPLE_INTERVAL 1

float test_signal[LENGTH_OF_TEST_SIGNAL];

float bp_filter_coeff[N_FILTER_LENGTH] = {
           0.000119, -0.000248, -0.001115, -0.002123, -0.002464, 
           -0.001282, 0.001674, 0.005529, 0.008370, 0.008080, 
           0.003597, -0.004103, -0.012010, -0.016287, -0.014199, 
           -0.005745, 0.005983, 0.016050, 0.020000, 0.016050, 
           0.005983, -0.005745, -0.014199, -0.016287, -0.012010, 
           -0.004103, 0.003597, 0.008080, 0.008370, 0.005529, 
           0.001674, -0.001282, -0.002464, -0.002123, -0.001115, -0.000248, 0.000119};

float lp_filter_coeff[N_FILTER_LENGTH] = {
 2.06725220701327e-06, -6.09884844892567e-06, 2.02541892358229e-05, -4.96746682161938e-05, 9.95591974012224e-05, 
  -0.000170560703325162, 0.000253547380759513, -0.000325383079664235, 0.000347828007832404, -0.000271424812599141, 
  4.50730865333464e-05, 0.000369928573544934, -0.000984675231987331, 0.00177097073629292, -0.00265779282632839,
  0.00353874724111293, -0.00429021941480392, 0.00479644446729574, 0.995022818906315, 0.00479644446729574, -0.00429021941480392,
  0.00353874724111293, -0.00265779282632839, 0.00177097073629292, -0.000984675231987331, 0.000369928573544934, 4.50730865333464e-05, 
  -0.000271424812599141, 0.000347828007832404, -0.000325383079664235, 0.000253547380759513, -0.000170560703325162, 9.95591974012224e-05, 
  -4.96746682161938e-05, 2.02541892358229e-05, -6.09884844892567e-06, 2.06725220701327e-06
  /*-6.23662687966491e-07, 5.75404802880169e-06, 4.34089467349912e-05, -1.01640755713296e-19, -0.000325894993210802, 
  -0.000438464617030089, 0.000867592756797369, 0.00257689530949527, -2.29275348792109e-18, -0.00731501973574878, 
  -0.00713175968912047, 0.0108895001432393, 0.0262658049312831, -9.94769493915627e-18, -0.0568754279957540, 
  -0.0531523725639640, 0.0871561685705125, 0.297433423433205, 0.400002030236440, 0.297433423433205, 0.0871561685705125, 
  -0.0531523725639640, -0.0568754279957540, -9.94769493915627e-18, 0.0262658049312831, 0.0108895001432393, -0.00713175968912047, 
  -0.00731501973574879, -2.29275348792109e-18, 0.00257689530949527, 0.000867592756797372, -0.000438464617030090, -0.000325894993210803, 
  -1.01640755713296e-19, 4.34089467349917e-05, 5.75404802880140e-06, -6.23662687966491e-07*/
  
          /* 0.000326, 0.000692, 0.001207, 0.001891, 0.002756, 
           0.003806, 0.005036, 0.006430, 0.007961, 0.009591, 
           0.011275, 0.012958, 0.014582, 0.016086, 0.017413, 
           0.018507, 0.019325, 0.019829, 0.020000, 0.019829, 
           0.019325, 0.018507, 0.017413, 0.016086, 0.014582, 
           0.012958, 0.011275, 0.009591, 0.007961, 0.006430, 
           0.005036, 0.003806, 0.002756, 0.001891, 0.001207, 0.000692, 0.000326*/};

float volatile in_array[LENGTH_OF_SIGNAL]; 
float volatile after_BPF[LENGTH_OF_SIGNAL];
float after_cosmult[LENGTH_OF_SIGNAL];
float after_LPF[LENGTH_OF_SIGNAL];

IntervalTimer timer0;
float cosine_lut[LENGTH_OF_DAC]; 
int dac_lut[LENGTH_OF_DAC]; 
float twopi = 3.14159265359 * 2;

int volatile index_test_signal;
int volatile index_in_array;
int volatile zero_phase_index;
int volatile counter;
boolean volatile data_ready_flag;

int n_mid_coef = (N_FILTER_LENGTH-1)/2;
//int n_mid_coef = 2; //should be (N_FILTER_LENGTH-1)/2, but this works. Needs figured out why

//-----------------------------------------------------------------
void cosine_LUT() {
   for(int i = 0; i < LENGTH_OF_DAC; i++) {
     cosine_lut[i] = cos(twopi*((float) i)/ LENGTH_OF_DAC);   
   }
}

//-----------------------------------------------------------------
void dac_LUT() {
   for(int i = 0; i < LENGTH_OF_DAC; i++) {
     dac_lut[i] = int ((1 + cosine_lut[i])*2047);   
   }
}

//-----------------------------------------------------------------
void execute_LPF() {
  after_LPF[index_in_array] = after_cosmult[index_in_array] * lp_filter_coeff[0];
  for (int fir_coef_index = 1; fir_coef_index < N_FILTER_LENGTH; fir_coef_index++) {
    int fir_delayline_index = index_in_array - fir_coef_index;
    if (fir_delayline_index < 0) {
      fir_delayline_index += N_FILTER_LENGTH;
    }
    after_LPF[index_in_array] += after_cosmult[fir_delayline_index] * lp_filter_coeff[fir_coef_index];
  }  
}

//-----------------------------------------------------------------
void execute_BPF() {
  after_BPF[index_in_array] = in_array[index_in_array] * bp_filter_coeff[0];
  for (int fir_coef_index = 1; fir_coef_index < N_FILTER_LENGTH; fir_coef_index++) {
    int fir_delayline_index = index_in_array - fir_coef_index;
    if (fir_delayline_index < 0) {
      fir_delayline_index += N_FILTER_LENGTH;
    }
    after_BPF[index_in_array] += in_array[fir_delayline_index] * bp_filter_coeff[fir_coef_index];
  }  
}

//-----------------------------------------------------------------
void execute_FIR(float in[], float out[], float h[]) {
  out[index_in_array] = in[index_in_array] * h[0];
  for (int fir_coef_index = 1; fir_coef_index < N_FILTER_LENGTH; fir_coef_index++) {
    int fir_delayline_index = index_in_array - fir_coef_index;
    if (fir_delayline_index < 0) {
      fir_delayline_index += N_FILTER_LENGTH;
    }
    out[index_in_array] += in[fir_delayline_index] * h[fir_coef_index];
  }  
}

//-----------------------------------------------------------------
void ISR() {
  // Update index variables
  index_in_array++;
  if(index_in_array >= LENGTH_OF_SIGNAL) index_in_array = 0;
  index_test_signal++;
  if(index_test_signal >= LENGTH_OF_TEST_SIGNAL) index_test_signal = 0;
  counter++;
  // Use simulated PMT signal & apply bandpass filter
  in_array[index_in_array] = test_signal[index_test_signal]; 
  execute_BPF();
  //execute_FIR(in_array, after_BPF, bp_filter_coeff);
  // Calculate index into in_array that corresponds to a zero-phase filter
  zero_phase_index = index_in_array - n_mid_coef;
  if (zero_phase_index < 0) zero_phase_index += N_FILTER_LENGTH;
  data_ready_flag = true;
  // Write to serial comma separated simulated value and zero-phase bandpass filtered value
  //Serial.print(in_array[zero_phase_index]); Serial.print(",");
  //Serial.println(after_BPF[index_in_array], 5);
}

//-----------------------------------------------------------------
void timer_setup() { //setup interrupt
    timer0.begin(ISR, TIMER_INT_MICROS);  
} 

//-----------------------------------------------------------------
float gain_magn(float h[], float omega) {
    float cos_term = 0.0;
    float sin_term = 0.0;
    for (int k=0; k<N_FILTER_LENGTH; k++) {
        cos_term += h[k] * cos(twopi*omega*k);
        sin_term += h[k] * sin(twopi*omega*k);
    }
    float gain_mag = sqrt(cos_term*cos_term + sin_term*sin_term);
    return gain_mag;
}

//-----------------------------------------------------------------
void setup_test_signal() {
  int mid, width;
  switch (SIMULATED_SIGNAL_SELECTION) {
    case 1: // raised cosine as float in range [0,2]
      for (int ii = 0; ii < LENGTH_OF_TEST_SIGNAL; ii++) {
        test_signal[ii] = 1.0 + cos(twopi*((float) ii)/ LENGTH_OF_DAC);
      }
      break;
    case 2: // impulse with range [0,1]
      for (int ii=0; ii<LENGTH_OF_TEST_SIGNAL; ii++) test_signal[ii] = 0.0;
      test_signal[LENGTH_OF_TEST_SIGNAL/2] = 1.0;
      break;
    case 3: // raised cosine using look up table, range is [0,4094]
      for (int ii=0; ii<LENGTH_OF_TEST_SIGNAL; ii++) {
        test_signal[ii] = dac_lut[ii % LENGTH_OF_DAC];
      }
      break;
    case 4: // rectangular pulse with range [0,1]
      mid = LENGTH_OF_TEST_SIGNAL/2; width = LENGTH_OF_TEST_SIGNAL/4;
      for (int ii=0; ii<LENGTH_OF_TEST_SIGNAL; ii++) test_signal[ii] = 0.0;
      for (int ii=mid-width/2; ii<mid+width/2; ii++) test_signal[ii] = 1.0;
      break;
    case 5: // rectangular modulation of raised cosine, range [0,2]
      mid = LENGTH_OF_TEST_SIGNAL/2; width = LENGTH_OF_TEST_SIGNAL/4;
      for (int ii=0; ii<LENGTH_OF_TEST_SIGNAL; ii++) test_signal[ii] = 0.0;
      for (int ii=mid-width/2; ii<mid+width/2; ii++) test_signal[ii] = 1.0;
      for (int ii = 0; ii < LENGTH_OF_TEST_SIGNAL; ii++) {
        test_signal[ii] *= 1.0 + cos(twopi*((float) ii)/ LENGTH_OF_DAC);
      }
      break;
    case 6: // Gaussian modulation of raised cosine, range [0,2]
      mid = LENGTH_OF_TEST_SIGNAL/2; width = LENGTH_OF_TEST_SIGNAL/8;
      for (int ii = 0; ii < LENGTH_OF_TEST_SIGNAL; ii++) {
        test_signal[ii] = exp( -pow((ii-mid),2.0)/(2.0*pow(width,2.0)) );
        test_signal[ii] *= (1.0 + cos(twopi*((float) ii)/ LENGTH_OF_DAC));
      }
      break;
    default: 
      break;
   }  
}

void setup() {
  // Initialize look up tables
  cosine_LUT();
  dac_LUT();
  // Set up test signal
  setup_test_signal();
  // Initialize counters & flags
  index_in_array = -1; 
  index_test_signal = -1; 
  counter = -1;
  data_ready_flag = false;
  // Normalize bandpass filter coefficients
  float gain_mag = gain_magn(bp_filter_coeff, 0.1);
  for (int k=0; k<N_FILTER_LENGTH; k++) {
      bp_filter_coeff[k] /= gain_mag;
  }
  // Normalize low pass filter coefficients
  gain_mag = gain_magn(lp_filter_coeff, 0.0);
  for (int k=0; k<N_FILTER_LENGTH; k++) {
      lp_filter_coeff[k] /= gain_mag;
  }
  Serial.begin(BAUD_RATE);
  Serial.flush();
  delay(1000); 
  timer_setup();
}

void loop() {
  int jj;
  if ( data_ready_flag && ((counter % OUTPUT_SAMPLE_INTERVAL) == 0) ) {
    /* // Write test signal & bandpass filtered values to serial port
    Serial.print(in_array[zero_phase_index]); Serial.print(",");
    Serial.println(after_BPF[index_in_array], 5); */
    jj = (counter-n_mid_coef) % LENGTH_OF_DAC;
    /*Serial.print(in_array[zero_phase_index]); Serial.print(",");
    Serial.println(cosine_lut[jj]*after_BPF[index_in_array], 5);*/
    for (int ii = 0; ii < N_FILTER_LENGTH; ii++) {
      int bp_index = index_in_array + ii;
      if (bp_index >= N_FILTER_LENGTH) bp_index -= N_FILTER_LENGTH;
      int lut_index = jj + ii;
      if (lut_index >= LENGTH_OF_DAC) lut_index -= LENGTH_OF_DAC;
      after_cosmult[bp_index] = after_BPF[bp_index] * cosine_lut[lut_index];
    }
    execute_LPF();
    Serial.print(in_array[zero_phase_index]); Serial.print(",");
    Serial.print(after_BPF[index_in_array], 5); Serial.print(",");
    Serial.print(after_cosmult[index_in_array], 5); Serial.print(",");
    Serial.println(after_LPF[index_in_array], 8);
    data_ready_flag = false;
  }
}
