naushad-rahman/LIFSrProj_F15/DSP/tests/test_BPF/test_BPF.ino

#include "/home/samuelwg/Arduino/libraries/ADC/ADC-master/ADC.h"
//#include "/home/samuelwg/Arduino/libraries/arduino/library/arduino.jar"

#define BAUD_RATE 115200
#define TIMER_INT_MICROS 200
#define LENGTH_OF_DAC 10
#define LENGTH_OF_SIGNAL 37
#define LENGTH_OF_TEST_SIGNAL 1001

#define N_FILTER_LENGTH 37


float bp_filter_coeff[N_FILTER_LENGTH] = {
  0.000313, 0.000472, 0.000426, -0.000000, -0.000941,
  -0.002438, -0.004382, -0.006499, -0.008370, -0.009499,
  -0.009417, -0.007804, -0.004587, 0.000000, 0.005424,
  0.010927, 0.015665, 0.018868, 0.020000, 0.018868,
  0.015665, 0.010927, 0.005424, 0.000000, -0.004587,
  -0.007804, -0.009417, -0.009499, -0.008370, -0.006499,
  -0.004382, -0.002438, -0.000941, -0.000000, 0.000426, 0.000472, 0.000313
};

float test_signal[LENGTH_OF_TEST_SIGNAL] = {
  1.        ,  0.96852063,  0.87606441,  0.72845228,  0.53497771,
  0.30782162,  0.06128546, -0.18910915, -0.42759769, -0.63916522,
  -0.8104917 , -0.93079065, -0.99248818, -0.99169991, -0.92847546,
  -0.80679535, -0.63432043, -0.42190948, -0.18293565,  0.06755558,
  0.3137936 ,  0.54027557,  0.73274247,  0.87907682,  0.97006559,
  0.99998026,  0.96693743,  0.87301743,  0.72413334,  0.52965874,
  0.30183748,  0.05501292, -0.19527519, -0.43326902, -0.64398478,
  -0.81415606, -0.9330691 , -0.99323728, -0.99087249, -0.92612361,
  -0.80306715, -0.62945059, -0.41620462, -0.17675492,  0.07382304,
  0.3197532 ,  0.5455521 ,  0.73700372,  0.88205451,  0.97157226,
  0.99992104,  0.96531605,  0.86993597,  0.71978582,  0.52431885,
  0.29584143,  0.0487382 , -0.20143352, -0.43892324, -0.64877891,
  -0.81778827, -0.93531071, -0.99394716, -0.99000594, -0.9237352 ,
  -0.79930725, -0.62455591, -0.41048332, -0.17056722,  0.08008758,
  0.32570017,  0.55080708,  0.74123588,  0.88499739,  0.97304058,
  0.99982235,  0.96365657,  0.86682018,  0.71540988,  0.51895827,
  0.2898337 ,  0.04246156, -0.2075839 , -0.44456014, -0.65354743,
  -0.8213882 , -0.93751539, -0.9946178 , -0.98910032, -0.92131032,
  -0.79551578, -0.61963657, -0.40474582, -0.16437278,  0.08634896,
  0.33163429,  0.55604033,  0.74543877,  0.88790533,  0.97447048,
  0.99968419,  0.96195904,  0.86367016,  0.71100569,  0.51357719,
  0.28381452,  0.03618325, -0.21372608, -0.45017948, -0.65829015,
  -0.8249557 , -0.93968307, -0.99524918, -0.98815564, -0.91884907,
  -0.79169292, -0.61469277, -0.39899234, -0.15817185,  0.09260693,
  0.33755531,  0.56125162,  0.74961224,  0.89077821,  0.97586191,
  0.99950656,  0.96022354,  0.86048605,  0.70657343,  0.50817585,
  0.27778415,  0.0299035 , -0.21985983, -0.45578106, -0.66300688,
  -0.82849063, -0.94181365, -0.99584126, -0.98717196, -0.91635155,
  -0.7878388 , -0.6097247 , -0.39322311, -0.15196468,  0.09886125,
  0.343463  ,  0.56644076,  0.75375611,  0.89361593,  0.97721481,
  0.99928947,  0.95845013,  0.85726796,  0.70211328,  0.50275444,
  0.2717428 ,  0.02362258, -0.22598489, -0.46136463, -0.66769744,
  -0.83199286, -0.94390704, -0.99639403, -0.9861493 , -0.91381785,
  -0.78395357, -0.60473257, -0.38743836, -0.14575151,  0.10511166,
  0.34935714,  0.57160753,  0.75787023,  0.89641837,  0.97852913,
  0.99903293,  0.95663888,  0.85401604,  0.69762542,  0.49731318,
  0.26569073,  0.01734072, -0.23210103, -0.46693   , -0.67236164,
  -0.83546224, -0.94596318, -0.99690747, -0.98508771, -0.91124807,
  -0.7800374 , -0.59971655, -0.3816383 , -0.13953259,  0.11135793,
  0.35523749,  0.57675174,  0.76195443,  0.89918542,  0.97980483,
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

};
float in_array[LENGTH_OF_SIGNAL];
float volatile after_BPF[LENGTH_OF_SIGNAL];
float zero_array[N_FILTER_LENGTH] = {0, 0, 0, 0, 0, 0, 0, 0, 0, 0, 0, 0, 0, 0, 0, 0, 0, 0, 0, 0, 0, 0, 0, 0, 0, 0, 0, 0, 0, 0, 0, 0, 0, 0, 0, 0, 0};

IntervalTimer timer0;


int volatile k; // For testing
int volatile n_samp;
int time;
int volatile y;




//----------------------------------------------------------
float fir_basic(float input, int ntaps, const float h[], float z[])
{
  int ii;
  float accum;

  /* store input at the beginning of the delay line */
  z[0] = input;

  /* calc FIR */
  accum = 0;
  for (ii = 0; ii < ntaps; ii++) {
    accum += h[ii] * z[ii];
  }

  /* shift delay line */
  for (ii = ntaps - 2; ii >= 0; ii--) {
    z[ii + 1] = z[ii];
  }

  return accum;
}

//-----------------------------------------------------------------
void ISR() {
  //***************************************
  // Test with a a regular cosine
  if (k >= 1002) {
    k = 0;
  }
  in_array[n_samp] = test_signal[k];
  if (n_samp >= LENGTH_OF_SIGNAL) {
    n_samp = 0;
    for (int i = 0; i <= N_FILTER_LENGTH; i++) {
      after_BPF[i] = fir_basic(in_array[i], N_FILTER_LENGTH,  bp_filter_coeff, zero_array);
      // Serial.print("\n\r after_BPF: ");
      Serial.println(after_BPF[i], 5);
    }
  }

  //*****************************************

  //Serial.print("\n\rinput_signal: ");
  // Serial.print(in_array[n_samp]);

  n_samp++;
  k ++;


}

//--------------------------------------------------------------
void timer_setup() { //setup interrupts
  timer0.begin(ISR, TIMER_INT_MICROS);

} //timer_setup()
//-----------------------------------------------------------

void setup() {

  n_samp = 0;
  k = 0;
  Serial.begin(BAUD_RATE);
  Serial.flush();
  delay(5000);
  timer_setup();
  Serial.print("\n\rHello! Right now we are testing the BPF");

}



void loop() {
  time = micros();



}
