naushad-rahman/LIFSrProj_F15/(commit log)

2015-05-13 Here are the Cad files for holding the PMT
    [Part1test1.STL]
2015-05-15 Updated the High Voltage .ino with correct pins
    [Parent Folder.kicad_pcb, Parent Folder.sch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]
2015-05-15 Updated the widgets on XYZ control
    [XYZboard-B_Cu.gbl, XYZboard-B_Mask.gbs, XYZboard-B_Paste.gbp, XYZboard-B_SilkS.gbo, XYZboard-Edge_Cuts.gbr, XYZboard-F_Cu.gtl, XYZboard-F_Mask.gts, XYZboard-F_Paste.gtp]
2015-05-15 3D printing
    [Part1test1.STL]
2015-05-29 Files for teensy UI
2015-06-03 Code for new high voltage board
2015-06-03 removed extra cad file
    [Part1test1.STL]
2015-06-04 This is the Optical Bench
    [OpticalBench.scad]
2015-06-04 Same holder, just made in openscad
    [PMT_holder.scad]
2015-06-10 DSP for teensy
2015-07-06 ipython notebooks to explore digital filters
2015-07-07 Laser Driver
    [Laser_Driver.PcbDoc, Laser_Driver.PrjPcb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]
2015-07-07 contine to test filters & add a pdf book on practical filter design
2015-07-07 calculate the bandpass filter gain at 1 kHz - yes, this method works
2015-07-07 normalize filter coefficients and test using them
2015-07-08 finish up zero-phase FIR filter notebook (150706_...)
2015-07-08 update figure showing indexing for zero-phase shift FIR filter
2015-07-08 new notebook to test filters with simulated PMT data
2015-07-09 Add impulse and pulse cases to basic filter tests in notebook
2015-07-09 printed off PMT signal
2015-07-10 fix data file and look at data from Teensy
    [RecordedData_2015710_91739.csv, fixed_file.csv]
2015-07-10 test_BPF in Ipython notebook not working
    [test_BPF.ino]
2015-07-10 start doing incremental development of teensy & python code, basic communication works
    [fixed_file.csv]
2015-07-10 Establish simple serial communication from Teensy to python code in a notebook
2015-07-11 Read data from serial port in Ipython notebook. Changed the fir filter as well in the arduino code.
2015-07-11 fix git conflicts and put my stuff in new directory
    [test_BPF_GN_150710.ino]
2015-07-11 Now the bandpass filter works. The old coefficients were the problem. I replaced them with the coefficients used in 150708_apply_filters_to_simulated_data.ipynb
    [test_BPF_GN_150710.ino]
2015-07-11 found and fixed pernicious bug using impulse signal. Filter is now truly zero-phase
    [test_BPF_GN_150710.ino]
2015-07-12 Added a case 3 where I made a cosine from the lut
2015-07-12 move seril.print statements to loop() from the interrupt function
2015-07-12 Added cosine multiplication, which seems to work correctly. Added low pass filter, which is having problems. Not ready to use or modify.
    [test_LPF_GN_150711.ino]
2015-07-12 fixed bug in coefficient magnitude function
    [test_BPF_GN_150711.ino, test_LPF_GN_150711.ino]
2015-07-13 start new effort to redesign teensy code to only do sample acquisition in interrupt and make all other calls in loop()
    [test_LPF_GN_150711.ino, test_filtersinloop_150713.ino]
2015-07-13 All filtering works correctly
    [test_filtersinloop_150713.ino]
2015-07-14 things work up until the low pass filter. I think the problem is with doing the 2nd zero-phase filter (i.e., low pass filter). The indexing gets out of whack (at least by comparison with the working 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
    [test_filtersinloop_150713.ino]
2015-07-14 modify python code to do linear phase filters and test out. Works good
2015-07-14 final check in before modifying code from zero-phase to linear phase filters
2015-07-14 no output is generated on the serial port by the Teensy
2015-07-14 low pass filter works. Everything is called in loop(). The low pass filter is FIR linear phase and not zero phase
2015-07-14 slight modification to code: put filter coefficient normalization inside a function
2015-07-14 HV, DC laser driver, Low pass filter
    HV and DC laser driver verified and working. Need to test the Low pass
    filter with the test vectors.
2015-07-15 Started to integrate everything but stuck at zero phase shift for BPF
    [test_all.ino]
2015-07-22 Python code to interface with Teensy DAQ
    First steps to transferring notebook to single python
2015-07-24 Python Scripts for Plotting
    Instead of the using the notebook, we will use python files for data
    collection. I added buttons on the widget to control the high voltage.
2015-07-24 Adding Buttons and changing serial format
    Changed byte sending to int for time and float for PMT signal output.
    Added buttons for the widget to control the high voltage. Took this code
    and made a .py file.
2015-07-27 Analog LPF before Teensy
    To remove high frequency aliasing of noise above our sampling rate of
    10kHz
2015-07-27 Recorded results for tests for the noise
    [DC_DSP_150714_KD.ino, teensyData.py]
2015-07-27 Trash Recorded Data
    [2015722_144255.csv, 2015722_14468.csv, 2015722_144925.csv, 2015722_145520.csv, 2015722_151710.csv, 2015727_101458.csv, 2015727_101820.csv, 2015727_102231.csv]
2015-07-28 PMT Raw Data Test
    Testing the RAW Data from the PMT in several scenarios. See readme.txt.
    testing folder contains csv files and pictures.
    [test_raw_data_150728_PMTcovered_lights_off.csv, test_raw_data_150728_PMTcovered_lights_on.csv, test_raw_data_150728_blank_slide.csv, test_raw_data_150728_no_slide_laser_off.csv, test_raw_data_150728_no_slide_laser_on.csv, test_raw_data_150728_rhodamine.csv]
2015-07-29 Correct ADC read bug
    10 bit to 12 bit resolution in analog read function.
    [DC_DSP_150714_KD.ino]
2015-07-30 Analog Filter design to filter 5kHz
2015-07-30 Plot all data after experiment
    On the click of the quit button, all data will be plotted for analysis.
2015-07-30 Prep for today's tests
    Our system can sample at 10 kHz. We will use this sampling rate for the
    tests today.
2015-08-04 Tried new filter coefficients and got a better result with Gaussian test
2015-08-04 XYZ Joystick Controller
    Get rid of junk and put in XYZ Joystick controller
    [XYZboard-B_Cu.gbl, XYZboard-B_Mask.gbs, XYZboard-B_Paste.gbp, XYZboard-B_SilkS.gbo, XYZboard-Edge_Cuts.gbr, XYZboard-F_Cu.gtl, XYZboard-F_Mask.gts, XYZboard-F_Paste.gtp]
2015-08-07 Changes to High Voltage
    We changed the HV to decrease sparking within the channels. This setting
    gives us 700 volts for insertion instead of 1kvolts and we don't see
    sparking.
2015-08-07 Data from Aug 7 flow tests
    Data taken from experiments to see flow in channels
2015-08-11 Added comments to help distinguish between high voltage parts and DSP parts
2015-08-11 Made a comment for the High voltage part of code
2015-08-11 Laser Driver Updates
    [Laser_Driver.PcbDoc, Laser_Driver.PrjPcb, driver.SchDoc]
2015-08-12 Optical Bench
    [Optical Bench.scad, Sample Holder.scad]
2015-08-12 Update on after PMT circuitry
2015-09-17 Updating readme for new semester
    I copied all the code over from Spring/Summer, as we will be building
    off of their work.
2015-09-22 Update README.md
    I moved all of the code from Spring/Summer over here for us to use and build off of.
2015-10-06 The Python code is now correctly communicating with the Teensy!
    [TeensyDataWrite.ino, tagSearcher.py, teensyData.py]
2015-10-08 Added tag for microfluidic device number. Rewrote large chunks of teensyData.py to add multithreaded processesing. This still needs testing and debugging.
2015-10-08 Now with more threads! ...and more missed time.
    [teensyData.py]
2015-10-08 Removed the pd stuff, as it is no longer needed.
    [TeensyDataWrite.ino, teensyData.py]
2015-10-13 Experimenting with serial stuff
    [20151013_101610.csv, 20151013_105448.csv, 20151013_110938.csv]
2015-10-13 Added laser characterization data and plots
    [Laser_Driver.PcbDoc, Laser_Driver.PrjPcb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]
2015-10-13 Serial issues are mostly better time is now an unsigned long, deques are being used instead of queues, and packets are now being sent every 125 usec. This will be improved upon in the future.
    [TeensyDataWrite.ino, teensyData.py]
2015-10-20 Added code to determine number of missed packets.
    [teensyData.py]
2015-10-20 Data and graphs on laser characterization at different voltages over 5 minutes
    [DATA08.CSV, volts10.CSV, volts11.CSV, volts7.CSV, volts8.CSV, volts9.CSV]
2015-10-22 working with python serial code
    [20151022_111106.csv, 20151022_111209.csv, 20151022_111209edit.csv, 20151022_112607.csv, 20151022_114339.csv, 20151022_115134.csv, 20151022_115226.csv, 20151022_115305.csv]
2015-10-25 Serial communication is (mostly) fixed!
    [TeensyDataWrite.ino, teensyData.py]
2015-10-29 Two-way serial communication implemented.
    [20151029_112808.csv, 20151029_112851.csv, 20151029_115147.csv, 20151029_130014.csv, 20151029_132239.csv, 20151029_133957.csv, 20151029_134411.csv, 20151029_134431.csv]
2015-11-03 New processing code for python workstation processing and significant updates to teensyData.py. The new updates include processing and alterations to the graphing
2015-11-06 Modifications to python interface with Teensy and processing operations including data filtering
2015-11-18 small fixes to teensyData.py UI while reviewing code with Jared
    [teensyData.py]
2015-12-01 Added command line flag options and error handling for com port.
    [TeensyDataWrite.ino, teensyData.py]
2015-12-03 small fix to data logging
    [teensyData.py]
2015-12-15 Final device log
2015-12-16 Removing outdated CAD file
    [Optical Bench.scad]
2015-12-16 Create CAD
2015-12-16 CAD: uploaded current 3d files and how to run the system
    [490HV_SampleConnector.ipt, 490HV_SampleConnector.stl, 490OpticalSystem.ipt, 490OpticalSystem.stl, Optical_Bench.scad, Optical_Bench_current.stl, PMT_holder.scad, Part1test1.STL]
